edwino-stein/ufrr-16.2-ise-trabalho_final/WebManager/img/pet2.jpg

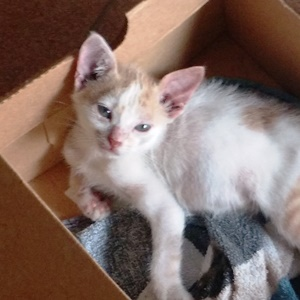
WebManager/img/pet2.jpg
