edwino-stein/ufrr-16.2-ise-trabalho_final/WebManager/img/pet1.jpg

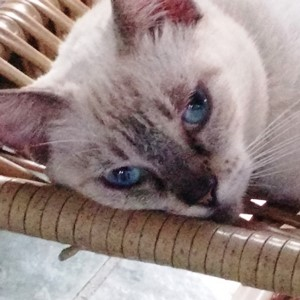
WebManager/img/pet1.jpg
