edwino-stein/ufrr-16.2-ise-trabalho_final/README.MD

# Trabalho Final de Sistemas Embarcados 2016.2

 - Instituição: Universidade Federal de Roraima
 - Professor: Herbet Oliveira Rocha
 - Componenetes:
    - Edwino Alberto Lopes Stein
    - Pedro Daniel da Silva Gohl

## Bibliotecas necessárias:
- Servo (Micro servo 9g):
    - Compatível com a biblioteca **Servo.h** padrão do Arduino
- MsTimer2:
    - Disponível para download pelo gerenciador de bibliotecas da IDE do Arduino
    - Também Disponível na [Página da PJRC](https://www.pjrc.com/teensy/td_libs_MsTimer2.html)
- HC-SR04 Ultrasonic sensor:
    - Disponível no [Repositório Felipeflop](https://github.com/filipeflop/Ultrasonic)
    - Também no arquivo **Libs/HC-SR04 Ultrasonic sensor.zip**
- MFRC522 RFID sensor:
    -  Disponível no [Repositório de miguelbalboa](https://github.com/miguelbalboa/rfid)
    -  Também no arquivo **Libs/MFRC522 RFID sensor.zip**

## Utilizando comunicação serial com programa externo
Para a comunição serial **funcionar sem a IDE do Arduino**, é necessário realizar um workaround no Arduino para desabilitar o **autoreset**, como é ilustrado neste [artigo do Arduino playground](http://playground.arduino.cc/Main/DisablingAutoResetOnSerialConnection).
Para o Arduino Uno, basta conectar um capacitor de **10µF** nos pinos GND (polo negativo) e RESET (polo positivo).

## WebManager
É necessário realizar o workaround citado anteriormente para poder executar o script **startSerialServer.sh** passando como parâmetro o caminho para o dispositivo serial, então basta configuar o documentRoot do servidor HTTP para o diretório **WebManager/**.

OBS.: É necessário ter instalado o PHP 5.5+.
OBS.: A aplicação só foi testada no Ubuntu 16.04.
OBS.: O usuário do servidor HTTP deve ter permissão de escrita no dispositivo serial.

###### OBS.: As imagens dos componentes do relatório foram baseadas nas imagens dos componentes de [circuits.io](https://circuits.io/).
