edwino-stein/ufrr-16.2-ise-trabalho_final/WebManager/img/coxa.png

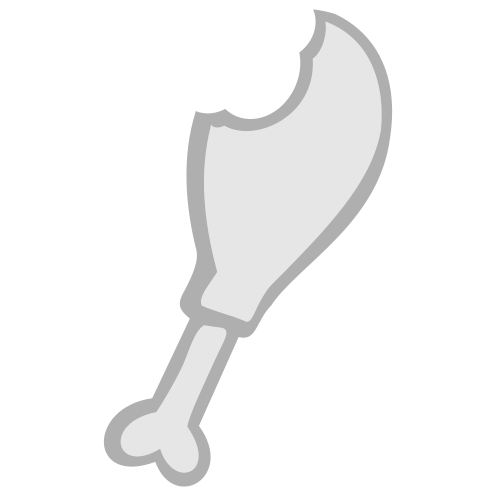
WebManager/img/coxa.png
