edwino-stein/ufrr-16.2-ise-trabalho_final/Imagens/componentes/arduino.png

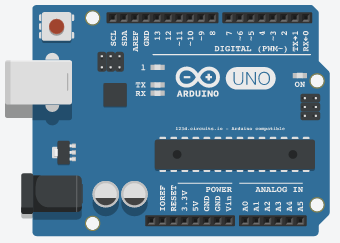
Imagens/componentes/arduino.png
