edwino-stein/ufrr-16.2-ise-trabalho_final/Imagens/componentes/proto mini.png

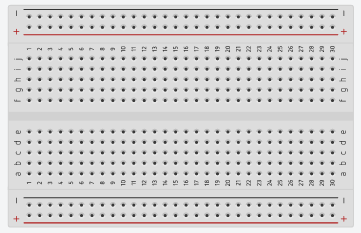
Imagens/componentes/proto mini.png
