edwino-stein/ufrr-16.2-ise-trabalho_final/Imagens/componentes/proto.png

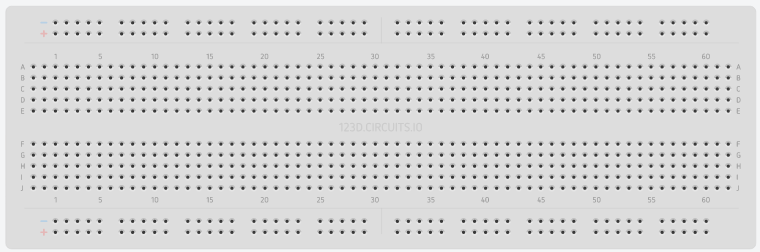
Imagens/componentes/proto.png
