edwino-stein/ufrr-16.2-ise-trabalho_final/Imagens/componentes/rfid.png

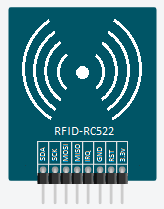
Imagens/componentes/rfid.png
