edwino-stein/ufrr-16.2-ise-trabalho_final/Imagens/componentes/ultra.png

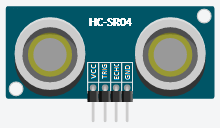
Imagens/componentes/ultra.png
