edwino-stein/ufrr-16.2-ise-trabalho_final/(commit log)

2017-02-20 Adicionando sistema de gerenciamento de nível de comida
2017-02-20 Definindo constantes de confiração do sensor ultrassônico no arquivo config.h
2017-02-20 Adicionando sistema de gerenciamento da comporta de comida
2017-02-20 Adicionando suporte a callbacks para comunicação serial
2017-02-20 Corrigindo nome de variável
    [foodMeasurer.cpp]
2017-02-20 Adicionando controlador do sensor de RFID
2017-02-25 Adicionando controlador para o pushbutton
2017-02-25 Adicionando controlador de comportamento para o LED
2017-02-25 Adicionando suporte a um interruptor para melhor controle do servo
2017-02-25 Corrigindo problema com a inicialização do controlador RFID
    [rfidController.cpp]
2017-02-25 Adicionando suporte para cadastro de RFID através do push button
2017-02-25 Permitindo a contagem de tempo para acionar a rotina de servir comida
2017-02-25 Adicionando feedback para quando o RFID é registrado
2017-02-25 Adicionando rotina para o servimento da comida
2017-02-26 Permitindo que o botão force a rotina de servir comida
2017-02-26 Integrando metidor de comida no reservatório
2017-02-28 Corrigindo problemas com o fluxo de definição de tempo por comando serial
    [Firmware.ino]
2017-02-28 Corrindo um pequeno detalhe no reset do tempo por comando serial
    [Firmware.ino]
2017-02-28 Padronozando o formato de LOGs
2017-02-28 Adicionando action para o WebManager
2017-03-02 Adicionando imagens para o relatório
2017-03-03 Adicionando alguns videos de testes realizados
